Tecnologic/floor-heating-controller-s2/README.md

# floor-heating-controller-s2
 with current controlled valve acutators
