Tecnologic/floor-heating-controller-s2/sim/diff_to_single.asc

C1: cap; 100n
C2: cap; 100n
C3: cap; 1n
L1: ind; 16.3m; Rser=42
R1: res; 0.1
R2: res; 330; tol=1
R3: res; 330; tol=1
R4: res; 47k; tol=1
R5: res; 47k; tol=1
R6: res; 47k; tol=1
R7: res; 47k; tol=1
R8: res; 330
U2: OP191
V1: voltage; PULSE(0 5 22.5u 1u 1u 5u 50u)
V2: voltage; PULSE(0 5 2.5u 1u 1u 45u 50u)
V3: voltage; 3.3
V4: voltage; 2.5
Named nets: 0, OUT
.tran 10m
