Tecnologic/floor-heating-controller-s2/floor-heating-controller-s2.kicad_pcb

## KiCad design floor-heating-controller-s2.kicad_pcb (2022-12-08)

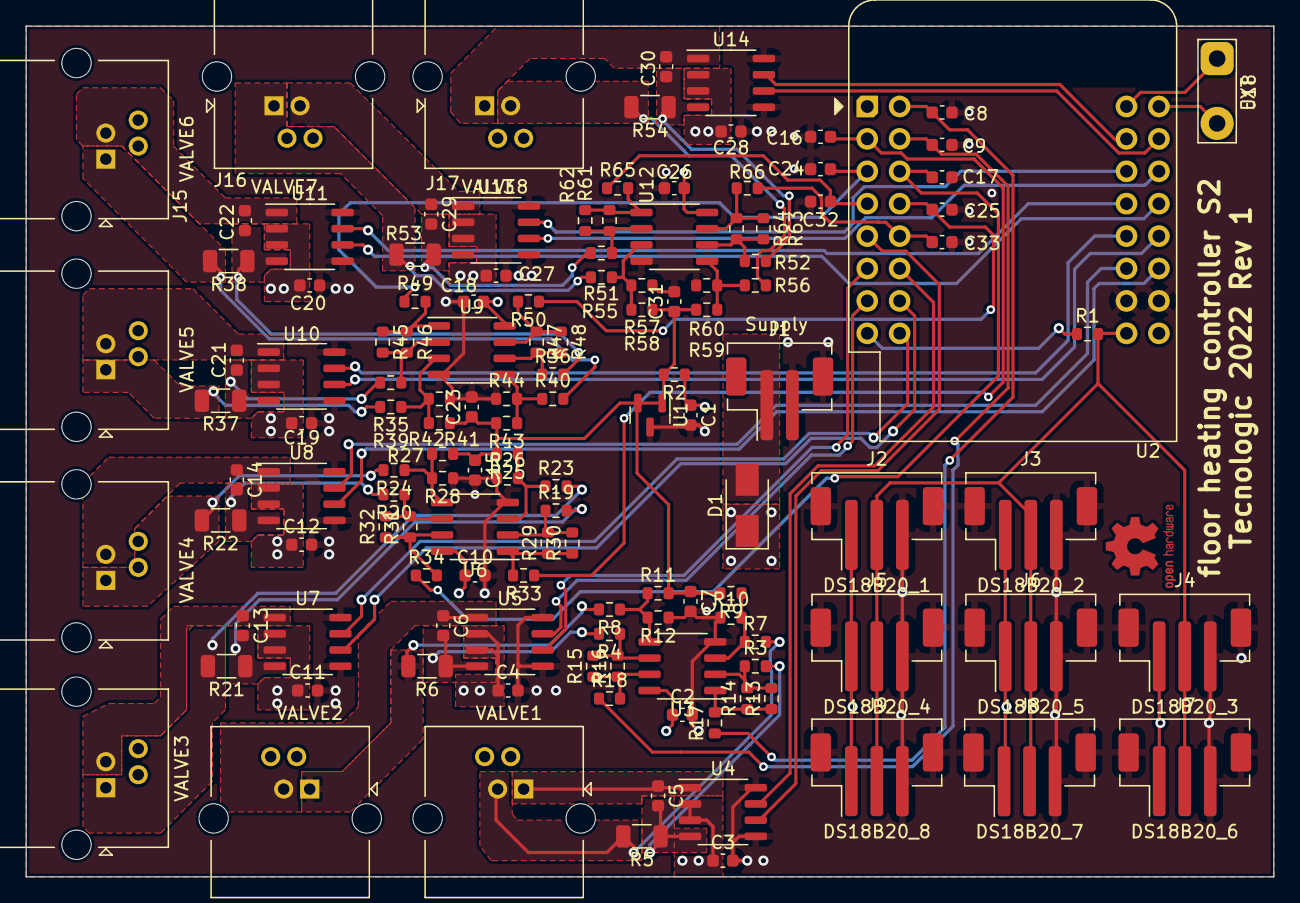
[picture p1: board floor-heating-controller-s2.kicad_pcb from above]

Board: 4 copper layers, 97.8 x 66.7 mm, 132 parts (0 on the bottom side), 80 nets.

Parts:
C1, C2, C3, C4, C5, C6, C7, C10, C11, C12, C13, C14, C15, C18, C19, C20, C21, C22, C23, C26, C27, C28, C29, C30, C31: 100n; C_0603_1608Metric
C8, C9, C16, C17, C24, C25, C32, C33: 1n; C_0603_1608Metric
D1: SS54; D_SMA
J1: Supply; JST_PH_B2B-PH-SM4-TB_1x02-1MP_P2.00mm_Vertical
J2: DS18B20_1; JST_PH_B3B-PH-SM4-TB_1x03-1MP_P2.00mm_Vertical
J3: DS18B20_2; JST_PH_B3B-PH-SM4-TB_1x03-1MP_P2.00mm_Vertical
J4: DS18B20_3; JST_PH_B3B-PH-SM4-TB_1x03-1MP_P2.00mm_Vertical
J5: DS18B20_4; JST_PH_B3B-PH-SM4-TB_1x03-1MP_P2.00mm_Vertical
J6: DS18B20_5; JST_PH_B3B-PH-SM4-TB_1x03-1MP_P2.00mm_Vertical
J7: DS18B20_6; JST_PH_B3B-PH-SM4-TB_1x03-1MP_P2.00mm_Vertical
J8: DS18B20_7; JST_PH_B3B-PH-SM4-TB_1x03-1MP_P2.00mm_Vertical
J9: DS18B20_8; JST_PH_B3B-PH-SM4-TB_1x03-1MP_P2.00mm_Vertical
J10: VALVE1; RJ14_Connfly_DS1133-S4_Horizontal
J11: VALVE2; RJ14_Connfly_DS1133-S4_Horizontal
J12: VALVE3; RJ14_Connfly_DS1133-S4_Horizontal
J13: VALVE4; RJ14_Connfly_DS1133-S4_Horizontal
J14: VALVE5; RJ14_Connfly_DS1133-S4_Horizontal
J15: VALVE6; RJ14_Connfly_DS1133-S4_Horizontal
J16: VALVE7; RJ14_Connfly_DS1133-S4_Horizontal
J17: VALVE8; RJ14_Connfly_DS1133-S4_Horizontal
J18: EXT; TestPoint_2Pads_Pitch5.08mm_Drill1.3mm
R1: 1k; R_0603_1608Metric
R2, R3, R4, R7, R8, R17, R18, R19, R20, R23, R24, R33, R34, R35, R36, R39, R40, R49, R50, R51, R52, R55, R56, R65, R66: 330R; R_0603_1608Metric
R5, R6, R21, R22, R37, R38, R53, R54: 0R1; R_1206_3216Metric
R9, R10, R11, R12, R13, R14, R15, R16, R25, R26, R27, R28, R29, R30, R31, R32, R41, R42, R43, R44, R45, R46, R47, R48, R57, R58, R59, R60, R61, R62, R63, R64: 47k; R_0603_1608Metric
U1: CJ431; SOT-23
U2: WeMos_S2_mini; WEMOS_S2_mini
U3, U6, U9, U12: LM358; SO-8_3.9x4.9mm_P1.27mm
U4, U5, U7, U8, U10, U11, U13, U14: L9110S; SO-8_3.9x4.9mm_P1.27mm

Connections:
+2V5: C7.1, C15.1, C23.1, C31.1, R2.2, R9.2, R11.2, R25.2, R27.2, R41.2, R43.2, R57.2, R59.2, U1.1 (K), U1.2 (REF)
+3V3: C2.1, C10.1, C18.1, C26.1, R1.1, U2.8 (3V3), U3.8 (V+), U6.8 (V+), U9.8 (V+), U12.8 (V+)
+5V: C1.1, C3.1, C4.1, C11.1, C12.1, C19.1, C20.1, C27.1, C28.1, D1.1 (K), J2.1, J3.1, J4.1, J5.1, J6.1, J7.1, J8.1, J9.1, R2.1, U2.9 (VBUS), U4.2 (VCC), U4.3 (VCC), U5.2 (VCC), U5.3 (VCC), U7.2 (VCC), U7.3 (VCC), U8.2 (VCC), U8.3 (VCC), U10.2 (VCC), U10.3 (VCC), U11.2 (VCC), U11.3 (VCC), U13.2 (VCC), U13.3 (VCC), U14.2 (VCC), U14.3 (VCC)
/DS18B20: J2.2, J3.2, J4.2, J5.2, J6.2, J7.2, J8.2, J9.2, R1.2, U2.25 (GPIO15)
/motor_output_1/MOT1_A: C5.1, J10.1, U4.1 (OUT_A)
/motor_output_1/MOT1_B: J10.3, R5.2, R7.2
/motor_output_1/MOT2_A: C6.1, J11.3, U5.1 (OUT_A)
/motor_output_1/MOT2_B: J11.1, R6.2, R8.2
/motor_output_2/MOT1_A: C13.1, J12.3, U7.1 (OUT_A)
/motor_output_2/MOT1_B: J12.1, R21.2, R23.2
/motor_output_2/MOT2_A: C14.1, J13.3, U8.1 (OUT_A)
/motor_output_2/MOT2_B: J13.1, R22.2, R24.2
/motor_output_3/MOT1_A: C21.1, J14.3, U10.1 (OUT_A)
/motor_output_3/MOT1_B: J14.1, R37.2, R39.2
/motor_output_3/MOT2_A: C22.1, J15.3, U11.1 (OUT_A)
/motor_output_3/MOT2_B: J15.1, R38.2, R40.2
/motor_output_4/MOT1_A: C29.1, J16.3, U13.1 (OUT_A)
/motor_output_4/MOT1_B: J16.1, R53.2, R55.2
/motor_output_4/MOT2_A: C30.1, J17.1, U14.1 (OUT_A)
/motor_output_4/MOT2_B: J17.3, R54.2, R56.2
CUR1: C8.1, R17.1, U2.17 (GPIO1)
CUR2: C9.1, R18.1, U2.18 (GPIO2)
CUR3: C16.1, R33.1, U2.2 (GPIO3)
CUR4: C17.1, R34.1, U2.19 (GPIO4)
CUR5: C24.1, R49.1, U2.3 (GPIO5)
CUR6: C25.1, R50.1, U2.20 (GPIO6)
CUR7: C32.1, R65.1, U2.4 (GPIO7)
CUR8: C33.1, R66.1, U2.21 (GPIO8)
GND: C1.2, C2.2, C3.2, C4.2, C7.2, C8.2, C9.2, C10.2, C11.2, C12.2, C15.2, C16.2, C17.2, C18.2, C19.2, C20.2, C23.2, C24.2, C25.2, C26.2, C27.2, C28.2, C31.2, C32.2, C33.2, J1.2, J1.MP (MountPin), J2.3, J2.MP (MountPin), J3.3, J3.MP (MountPin), J4.3, J4.MP (MountPin), J5.3, J5.MP (MountPin), J6.3, J6.MP (MountPin), J7.3, J7.MP (MountPin), J8.3, J8.MP (MountPin), J9.3, J9.MP (MountPin), R10.1, R12.1, R26.1, R28.1, R42.1, R44.1, R58.1, R60.1, U1.3 (A), U2.10 (GND), U2.26 (GND), U3.4 (V-), U4.5 (GND), U4.8 (GND), U5.5 (GND), U5.8 (GND), U6.4 (V-), U7.5 (GND), U7.8 (GND), U8.5 (GND), U8.8 (GND), U9.4 (V-), U10.5 (GND), U10.8 (GND), U11.5 (GND), U11.8 (GND), U12.4 (V-), U13.5 (GND), U13.8 (GND), U14.5 (GND), U14.8 (GND)
IN1_A: U2.5 (GPIO9), U4.6 (IN_A)
IN1_B: U2.22 (GPIO10), U4.7 (IN_B)
IN2_A: U2.6 (GPIO11), U5.6 (IN_A)
IN2_B: U2.7 (GPIO12), U5.7 (IN_B)
IN3_A: U2.23 (GPIO13), U7.6 (IN_A)
IN3_B: U2.24 (GPIO14), U7.7 (IN_B)
IN4_A: U2.11 (GPIO16), U8.6 (IN_A)
IN4_B: U2.27 (GPIO17), U8.7 (IN_B)
IN5_A: U2.12 (GPIO18), U10.6 (IN_A)
IN5_B: U2.28 (GPIO21), U10.7 (IN_B)
IN6_A: U2.13 (GPIO33), U11.6 (IN_A)
IN6_B: U2.29 (GPIO34), U11.7 (IN_B)
IN7_A: U2.14 (GPIO35), U13.6 (IN_A)
IN7_B: U2.30 (GPIO36), U13.7 (IN_B)
IN8_A: U2.15 (GPIO37), U14.6 (IN_A)
IN8_B: U2.31 (GPIO38), U14.7 (IN_B)
unnamed: C5.2, R3.2, R5.1, U4.4 (OUT_B)
unnamed: C6.2, R4.2, R6.1, U5.4 (OUT_B)
unnamed: C13.2, R19.2, R21.1, U7.4 (OUT_B)
unnamed: C14.2, R20.2, R22.1, U8.4 (OUT_B)
unnamed: C21.2, R35.2, R37.1, U10.4 (OUT_B)
unnamed: C22.2, R36.2, R38.1, U11.4 (OUT_B)
unnamed: C29.2, R51.2, R53.1, U13.4 (OUT_B)
unnamed: C30.2, R52.2, R54.1, U14.4 (OUT_B)
unnamed: D1.2 (A), J1.1
unnamed: J18.1, U2.32 (GPIO40)
unnamed: J18.2, U2.16 (GPIO39)
unnamed: R7.1, R9.1, R10.2, U3.3 (+)
unnamed: R8.1, R11.1, R12.2, U3.5 (+)
unnamed: R13.1, R14.1, R17.2, U3.1
unnamed: R3.1, R13.2, R14.2, U3.2 (-)
unnamed: R15.1, R16.1, R18.2, U3.7
unnamed: R4.1, R15.2, R16.2, U3.6 (-)
unnamed: R19.1, R29.2, R30.2, U6.2 (-)
unnamed: R20.1, R31.2, R32.2, U6.6 (-)
unnamed: R23.1, R25.1, R26.2, U6.3 (+)
unnamed: R24.1, R27.1, R28.2, U6.5 (+)
unnamed: R29.1, R30.1, R33.2, U6.1
unnamed: R31.1, R32.1, R34.2, U6.7
unnamed: R35.1, R45.2, R46.2, U9.2 (-)
unnamed: R36.1, R47.2, R48.2, U9.6 (-)
unnamed: R39.1, R41.1, R42.2, U9.3 (+)
unnamed: R40.1, R43.1, R44.2, U9.5 (+)
unnamed: R45.1, R46.1, R49.2, U9.1
unnamed: R47.1, R48.1, R50.2, U9.7
unnamed: R51.1, R61.2, R62.2, U12.2 (-)
unnamed: R52.1, R63.2, R64.2, U12.6 (-)
unnamed: R55.1, R57.1, R58.2, U12.3 (+)
unnamed: R56.1, R59.1, R60.2, U12.5 (+)
unnamed: R61.1, R62.1, R65.2, U12.1
unnamed: R63.1, R64.1, R66.2, U12.7
