Tecnologic/floor-heating-controller-s2/software/fhcs2/src/main.cpp

/*
        (
        )\ ) (
     (()/( )\         (
        /(_)|(_)(    (  )(
     (_))_|_  )\   )\(()\
     | |_ | |((_) ((_)((_)
     | __)| / _ \/ _ \ '_|
     |(|/(|_\___/\___/_)
        )\())  (    ) ( /((        (  (
     ((_)\  ))\( /( )\())\  (    )\))(
        _((_)/((_)(_)|_))((_) )\ )((_))\
     | || (_))((_)_| |_ (_)_(_/( (()(_)
     | __ / -_) _` |  _|| | ' \)) _` |
     |_||_\___\__,_|\__||(|_||_|\__, |
            (      )    (    )\ )   )___/
            )\  ( /((   )\  (()/(( /(
        (((_) )\())( ((_)  /(_))(_))
        )\___(_))(()\ _   (_))((_)
     ((/ __| |_ ((_) |  / __|_  )
        | (__|  _| '_| |  \__ \/ /
         \___|\__|_| |_|  |___/___|

    Floor Heating Controller S2  2024 Alexander <tecnologic86@gmail.com> Evers

    This file is part of Floor Heating Controller S2.

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
        You should have received a copy of the GNU General Public License
        along with this program.  If not, see <http://www.gnu.org/licenses/>.
 */

#include "driver/gpio.h"
#include "esp_err.h"
#include "esp_log.h"
#include "freertos/FreeRTOS.h"
#include "freertos/task.h"
#include "hardware_layer.h"
#include "string.h"
#include <cstdint>
#include <stdio.h>

const char *TAG = "fhcs2";

extern "C" void app_main()
{

   vTaskDelay(10000 / portTICK_PERIOD_MS);
   hardware::Init();

   while (1)
   {
      static std::uint32_t counter = 0;
      static bool led = false;
      constexpr hardware::ValveController::channels_e chan =
          hardware::ValveController::CHANNEL_3;

      hardware::SetBoardLed(led);
      vTaskDelay(10 / portTICK_PERIOD_MS);
      counter++;
      static std::int32_t current = 0;

      hardware::valves[chan].move(1);

      if ((counter % 300) == 0)
      {
         led = true;
         current = 20000;
      }
      else if ((counter % 600) == 0)
      {
         led = false;
         current = 0;
      }
      printf(">cur:%ld\n>v:%ld\n>set:%ld\n", hardware::valves[chan].getCurrent(), hardware::valves[chan].getVoltage(), current);
      hardware::valves[chan].setSetCurrent(current);
   }
}
