Tecnologic/floor-heating-controller-s2/(commit log)

2022-11-27 start of a current controlled valve
    [floor-heating-controller-s2.kicad_pcb, floor-heating-controller-s2.kicad_sch, motor_output.kicad_sch]
2022-11-28 changed gain of opamps
    [floor-heating-controller-s2.kicad_sch, motor_output.kicad_sch]
2022-11-29 finished schematics
    [floor-heating-controller-s2.kicad_pcb, floor-heating-controller-s2.kicad_sch, motor_output.kicad_sch]
2022-11-30 first placing
    [floor-heating-controller-s2.kicad_pcb, floor-heating-controller-s2.kicad_sch, motor_output.kicad_sch]
2022-12-02 First routing cycle nearly complete
    [floor-heating-controller-s2.kicad_pcb, floor-heating-controller-s2.kicad_sch]
2022-12-03 production ready
    [floor-heating-controller-s2.kicad_pcb, floor-heating-controller-s2.kicad_sch]
2023-09-06 started costum component in esphome for motor control
2023-10-09 adc build but crashes
    [valve.cpp, valve.h]
2023-10-10 got adc kinda working
2023-10-31 started with 5.1.1 adc driver
2023-11-02 platformio arduino esp32 3.0 config
2023-11-15 added current calculation
2023-11-17 running with adc and pwm. needs scope for further debug
2023-12-17 arduino is anoying, no return values just useless logs.
2023-12-17 motor runs but l9220s is not what i expected it to be
2023-12-18 added final board config to build for both boards
2023-12-19 pwm is running, now figuring the analog part out.
2023-12-22 added adc readings
2023-12-22 print take to long
2023-12-24 changed pwm freq
2023-12-29 added voltage output stuff for first test of the motor model
2023-12-30 current and voltage direction made simular
2024-01-05 god way though the rework
    [hardware_layer.cpp, hardware_layer.h]
2024-01-12 found the issue with the hpoint on ledc
    [hardware_layer.cpp, hardware_layer.h, main.cpp]
2024-01-12 pwm seams to work as "center aligned"
2024-01-16 more investigation on current measurement. current measurement is only unidirectional for now.
2024-01-16 Need to fix PWM Pins to defined states during opperation on other channel
    [hardware_layer.h, main.cpp]
2024-01-18 current control is running in both directions
