Tecnologic/floor-heating-controller-s2/(notices)

Notices in the files:
software/fhcs2/src/main.cpp:
and/or modify it under the terms of the GNU General Public License as
published by the Free Software Foundation, either version 3 of the License,
or (at your option) any later version.
software/fhcs2/src/hardware_layer.cpp:
modify it under the terms of the GNU General Public License as published by
the Free Software Foundation, either version 3 of the License, or
(at your option) any later version.
